hanluu0710/handsfreereading/README.md

# handsfreereading
Senior Design - Hands-free reading
