hanluu0710/handsfreereading/Eye Tracking/Rassberry Pi Camera Mount.pptx

## Board & Camera Module 3 Case + Mount

- Raspberry Pi Camera Mount - Camera Module 3 Version by (https://www.printables.com/model/368788-raspberry-pi-camera-mount-camera-module-3-version/files)DocWeebl (https://www.printables.com/model/368788-raspberry-pi-camera-mount-camera-module-3-version/files) | Download free STL model | Printables.com (https://www.printables.com/model/368788-raspberry-pi-camera-mount-camera-module-3-version/files)
- Articulating Raspberry Pi Camera Mount for Prusa MK3 and MK2 by Sneaks | Download free STL model | Printables.com (https://www.printables.com/model/3407-articulating-raspberry-pi-camera-mount-for-prusa-m)
- Raspberry Pi 4B case with RPi camera 2 arm by Dominik (https://www.printables.com/model/301598-raspberry-pi-4b-case-with-rpi-camera-2-arm)Chuchlík (https://www.printables.com/model/301598-raspberry-pi-4b-case-with-rpi-camera-2-arm) | Download free STL model | Printables.com (https://www.printables.com/model/301598-raspberry-pi-4b-case-with-rpi-camera-2-arm)
