hanluu0710/handsfreereading/Senior Design Purchases.xlsx

Seller | Components | Price | Total spent: | $107.43
Rasberry Pi | Raspberry Pi 4 | $67.50
 | Camera Module | $27.50
 | Shipping | $12.43
