hanluu0710/handsfreereading/Senior Design BOM.xlsx

Component Name | Unit Cost | Unit # to get | Total Cost | Status | Description/Stock size/notes | Manufacturer Part Number | Notes
GC0308 0.3MP 120FPS Camera Module 30MP Sensors for Dynamic Picture, 80 degree black and | $18.37 |  |  |  |  | https://www.amazon.com/PLCPDM-GC0308-Sensors-Dynamic-Picture/dp/B0D6K51LKB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 | Must purchase on own due to foreign adversary limitations, ask if too high level and need to design by ourselves
Servo |  |  |  |  |  |  | Ask ECE schop
Rechargeable battery
protection circuit
prioritizer circuit
