hanluu0710/handsfreereading/Purchasing forms/Digikey Order 1.xlsx

DigiKey - Shopping Cart
Index | Quantity | Part Number | Manufacturer Part Number | Description | Unit of Measure | Customer Reference | Available | Backorder | Unit Price | Extended Price USD
1 | 2 | 296-36206-5-ND | TPS54531DDA | IC REG BUCK ADJ 5A 8SOPWR |  |  | 2 | 0 | 3.04 | 6.08
2 | 2 | 497-18060-1-ND | STUSB4500QTR | IC USB CONTROLLER I2C 24QFN |  |  | 2 | 0 | 2.22 | 4.44
3 | 2 | 497-6689-1-ND | ESDA25W | TVS DIODE 24VWM SOT323 |  |  | 2 | 0 | 0.45 | 0.90
4 | 4 | 497-16913-1-ND | ESDA25P35-1U1M | TVS DIODE 22VWM 41VC 1610 |  |  | 4 | 0 | 0.54 | 2.16
5 | 2 | 5399-SS52CT-ND | SS52 | 20V 550MV@5A 5A SMA(DO-214AC) |  |  | 2 | 0 | 0.11 | 0.22
6 | 1 | 1597-1203-ND | 108990003 | STEPPER MOTOR PM BIPOLAR 5V |  |  | 1 | 0 | 4.9 | 4.90
7 | 1 | 1528-3297-ND | 3297 | EVAL BOARD FOR DRV8833 |  |  | 1 | 0 | 5.95 | 5.95
8 | 2 | BAT54LT1GOSCT-ND | BAT54LT1G | DIODE SCHOTTKY 30V 200MA SOT23-3 |  |  | 2 | 0 | 0.14 | 0.28
9 | 2 | 5923-0686F8000-01CT-ND | 0686F8000-01 | FUSE BRD MNT 8A 32VAC 63VDC 0603 |  |  | 2 | 0 | 0.45 | 0.90
10 | 2 | 2223-UJ20-C-H-G-SMT-1-P16-TRCT-ND | UJ20-C-H-G-SMT-1-P16-TR | CONN RCPT USB 2.0 TYPE C SMD RA |  |  | 2 | 0 | 0.49 | 0.98
11 | 2 | 283-EXLA1V0606-6R8-RCT-ND | EXLA1V0606-6R8-R | FIXED IND 6.8UH 9A 20.8 MOHM SMD |  |  | 2 | 0 | 1.26 | 2.52
12 | 3 | 445-6390-1-ND | MLZ1608M4R7WT000 | FIXED IND 4.7UH 350MA 500 MOHM |  |  | 3 | 0 | 0.1 | 0.30
13 | 3 | 497-15315-1-ND | STL6P3LLH6 | MOSFET P-CH 30V 6A POWERFLAT |  |  | 3 | 0 | 1.72 | 5.16
14 | 4 | FDMC8327LCT-ND | FDMC8327L | MOSFET N-CH 40V 12A/14A 8MLP |  |  | 4 | 0 | 1.54 | 6.16
15 | 1 | 108-DP62J12S202HQ-ND | DP62J12S202HQ | DP SERIES ROCKER SWITCH |  |  | 1 | 0 | 3.73 | 3.73
16 | 2 | BC2733CT-ND | NTCS0805E3103FLT | THERMISTOR NTC 10KOHM 3430K 0805 |  |  | 2 | 0 | 0.79 | 1.58
17 | 2 | 505-LTC4162EUFD-LAD#TRPBFCT-ND | LTC4162EUFD-LAD#TRPBF | IC BATT MON LI-ION 1-8CELL 28QFN |  |  | 2 | 0 | 9.02 | 18.04
