hanluu0710/handsfreereading/Purchasing forms/ECE Senior Design Purchase Request - Digikey.xlsx

FOR SENIOR DESIGN USE ONLY
 |  |  |  |  | Today's Date: | 2026-10-31
College of Engineering Senior Design Purchase Request Form |  |  | Department Name: |  | Need-By Date: | 2026-11-07
 |  |  | ECE |  | SHIP TO INFORMATION
Vendor: | Digikey |  | Team Name / Project: |  | Your Name: | Han Luu
Website: | https://www.digikey.com/ |  | Hands-free Reading |  | Building Abbv.: | BHEE
Phone Number: | 18003444539 |  |  |  | Room Number: | 65
Vendor Contact: |  |  | Account Number: (do not change) |  | Phone Number: | 6265453735
Contact Email: | orders@digikey.com |  | 7600000796 |  | Email Address: | luum@purdue.edu
 |  |  | DIGIKEY ORDERS WITH MORE THAN 5 LINES ITEMS MUST ATTACH EXCEL DOWNLOAD OF SHOPPING CART FROM DIGIKEY CATALOG |  | Instructor: | Carla Zoltowski and Ryan Beasley
 |  |  | IF NO EXCEL DOWNLOAD ATTACH, REQUEST WILL BE REJECTED
PART NUMBER |  | ITEM DESCRIPTION & LINK |  |  |  | QUANTITY | UNIT COST | TOTAL COST
TPS54531DDA |  | IC REG BUCK ADJ 5A 8SOPWR https://www.digikey.com/en/products/detail/texas-instruments/TPS54531DDA/4172337 |  |  |  | 2.00 | $3.04 | $6.08
STUSB4500QTR |  | IC USB CONTROLLER I2C 24QFN https://www.digikey.com/en/products/detail/stmicroelectronics/STUSB4500QTR/9092189 |  |  |  | 2.00 | $2.22 | $4.44
ESDA25W |  | TVS DIODE 24VWM SOT323 https://www.digikey.com/en/products/detail/stmicroelectronics/ESDA25W/1037976 |  |  |  | 2.00 | $0.45 | $0.90
ESDA25P35-1U1M |  | TVS DIODE 22VWM 41VC 1610 https://www.digikey.com/en/products/detail/stmicroelectronics/ESDA25P35-1U1M/6230124 |  |  |  | 4.00 | $0.54 | $2.16
SS52 |  | 20V 550MV@5A 5A SMA(DO-214AC) https://www.digikey.com/en/products/detail/shenzhen-slkormicro-semicon-co-ltd/SS52/26370980 |  |  |  | 2.00 | $0.11 | $0.22
108990003 |  | STEPPER MOTOR PM BIPOLAR 5V https://www.digikey.com/en/products/detail/seeed-technology-co-ltd/108990003/5487797 |  |  |  | 1.00 | $4.90 | $4.90
3297 |  | EVAL BOARD FOR DRV8833 https://www.digikey.com/en/products/detail/adafruit-industries-llc/3297/6419360 |  |  |  | 1.00 | $5.95 | $5.95
BAT54LT1G |  | DIODE SCHOTTKY 30V 200MA SOT23-3 https://www.digikey.com/en/products/detail/onsemi/BAT54LT1G/918316 |  |  |  | 2.00 | $0.14 | $0.28
0686F8000-01 |  | FUSE BRD MNT 8A 32VAC 63VDC 0603 https://www.digikey.com/en/products/detail/bel-fuse-inc/0686F8000-01/7427698 |  |  |  | 2.00 | $0.45 | $0.90
UJ20-C-H-G-SMT-1-P16-TR |  | CONN RCPT USB 2.0 TYPE C SMD RA https://www.digikey.com/en/products/detail/same-sky-formerly-cui-devices/UJ20-C-H-G-SMT-1-P16-TR/24818576 |  |  |  | 2.00 | $0.49 | $0.98
EXLA1V0606-6R8-R |  | FIXED IND 6.8UH 9A 20.8 MOHM SMD https://www.digikey.com/en/products/detail/eaton-electronics-division/EXLA1V0606-6R8-R/16892708 |  |  |  | 2.00 | $1.26 | $2.52
MLZ1608M4R7WT000 |  | FIXED IND 4.7UH 350MA 500 MOHM TDK https://www.digikey.com/en/products/detail/tdk/MLZ1608M4R7WT000/2465149 |  |  |  | 3.00 | $0.10 | $0.30
STL6P3LLH6 |  | MOSFET P-CH 30V 6A POWERFLAT https://www.digikey.com/en/products/detail/stmicroelectronics/STL6P3LLH6/5170838 |  |  |  | 3.00 | $1.72 | $5.16
FDMC8327L |  | MOSFET N-CH 40V 12A/14A 8MLP https://www.digikey.com/en/products/detail/onsemi/FDMC8327L/3855013 |  |  |  | 4.00 | $1.54 | $6.16
DP62J12S202HQ |  | DP SERIES ROCKER SWITCH https://www.digikey.com/en/products/detail/c-k/DP62J12S202HQ/26715630 |  |  |  | 1.00 | $3.73 | $3.73
NTCS0805E3103FLT |  | THERMISTOR NTC 10KOHM 3430K 0805 https://www.digikey.com/en/products/detail/vishay-beyschlag-draloric-bc-components/NTCS0805E3103FLT/2615416 |  |  |  | 2.00 | $0.79 | $1.58
LTC4162EUFD-LAD#TRPBF |  | IC BATT MON LI-ION 1-8CELL 28QFN https://www.digikey.com/en/products/detail/analog-devices-inc/LTC4162EUFD-LAD-TRPBF/9446057 |  |  |  | 2.00 | $9.02 | $18.04
Shipping / Handling |  |  |  |  |  |  | $24.84 | $24.84
Requisition Total |  |  |  |  |  |  |  | $89.14
*** ALL BLUE CELLS are Mandatory *** Do Not Alter Formulas ***
Required Approvals |  |  |  | Business Office Use Only:
Instructor: |  |  |  | CC - Trans ID# |  | Credit Card# (last four only):
 | Signature |  | Date | Reimbursement / Check payment - Ref. Doc#
Comptroller/Fiscal:
 | Signature |  | Date | Is there a discount? Yes______ No ______ (Fill out the Form 41B)
