hanluu0710/handsfreereading/Circuit/handsfreereading_PCB/Reference_symbol/Ref_Sym/Batt_holder1122/1122.step

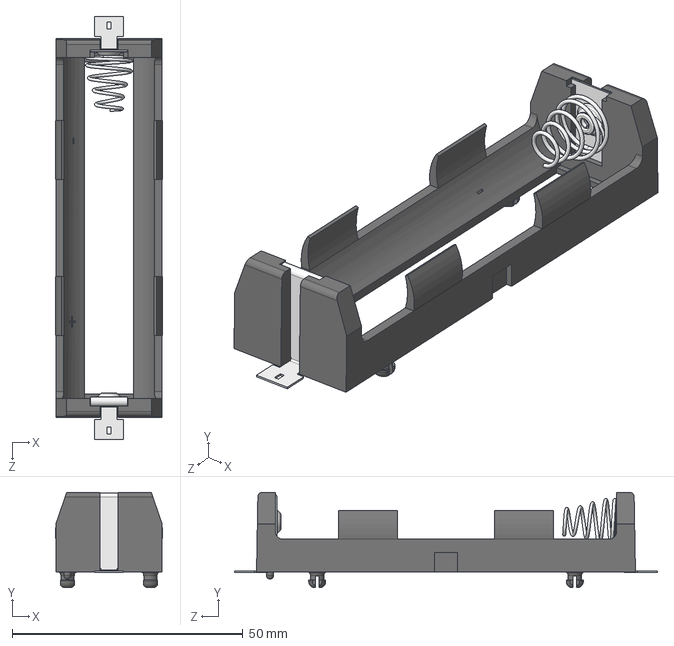
[picture p38: CAD file, 2026-11-04]
Circuit/handsfreereading_PCB/Reference_symbol/Ref_Sym/Batt_holder1122/1122.step
23.3 x 20.7 x 91.7 mm
