hanluu0710/handsfreereading/Eye Tracking/Rassberry Pi 4b Getting Started.pptx

Prototyping

Final version

WARNING

RP-008341-DS-1-raspberry-pi-4-datasheet.pdf (https://pip-assets.raspberrypi.com/categories/545-raspberry-pi-4-model-b/documents/RP-008341-DS-1-raspberry-pi-4-datasheet.pdf)

## Slide 2

Need a USB-C cable for power only.

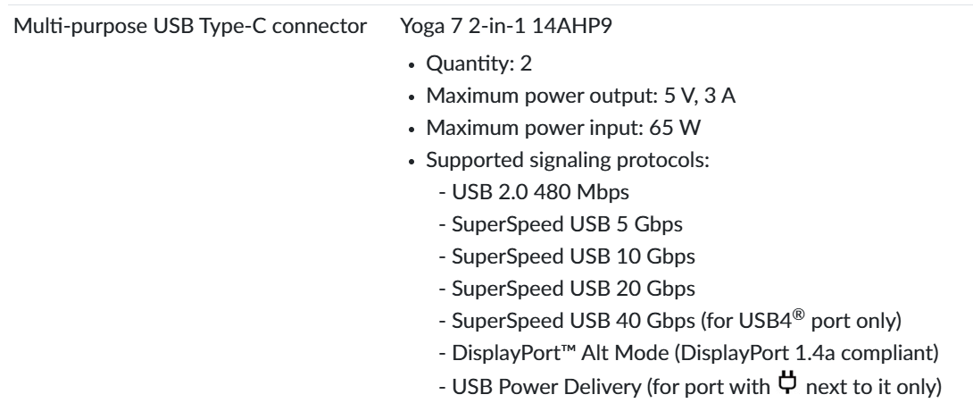
[picture p39: figure]
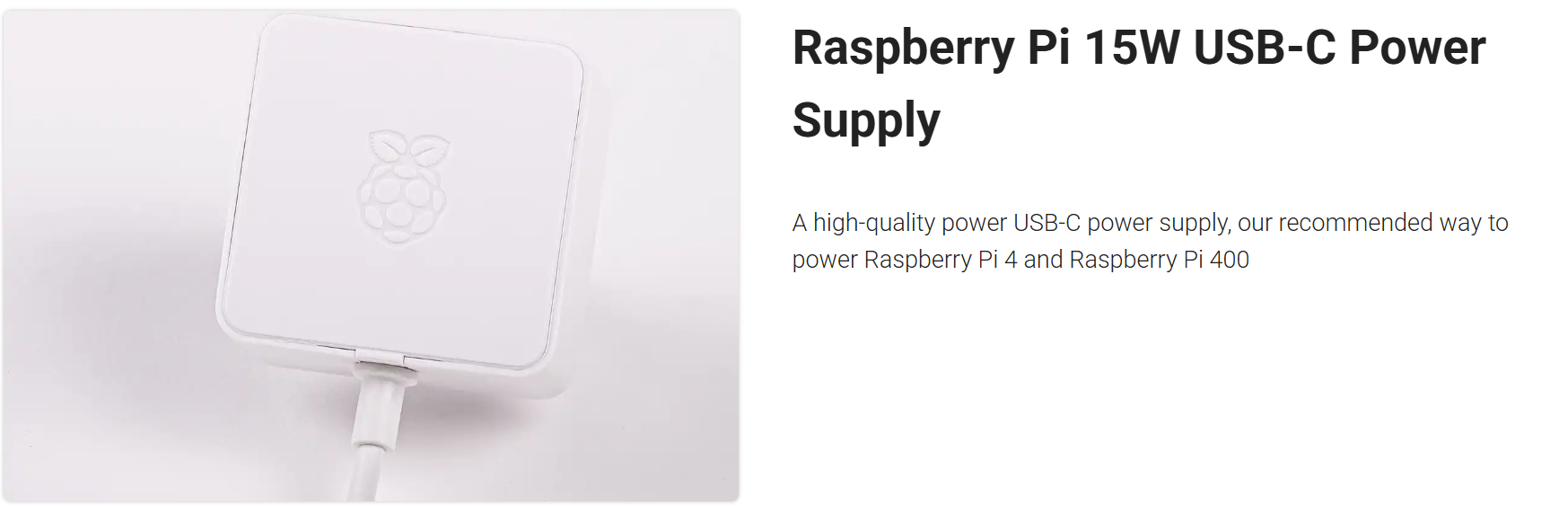
[picture p40: figure]

Optional

## Slide 3

If we did not purchase the pre-loaded SD card, we will have to follow these steps (https://www.raspberrypi.com/documentation/computers/getting-started.html#install).

If you want to work on this, you need a Micro SD card port on your laptop.

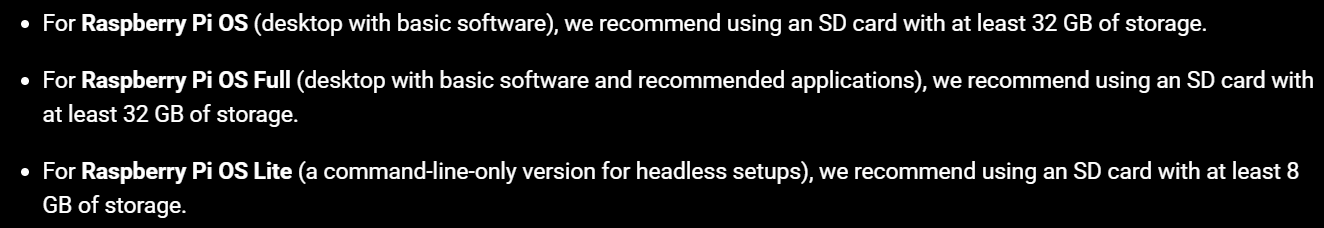
[picture p41: figure]

WARNING

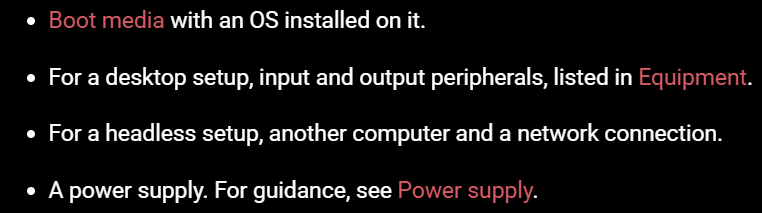
[picture p42: figure]

## Slide 4

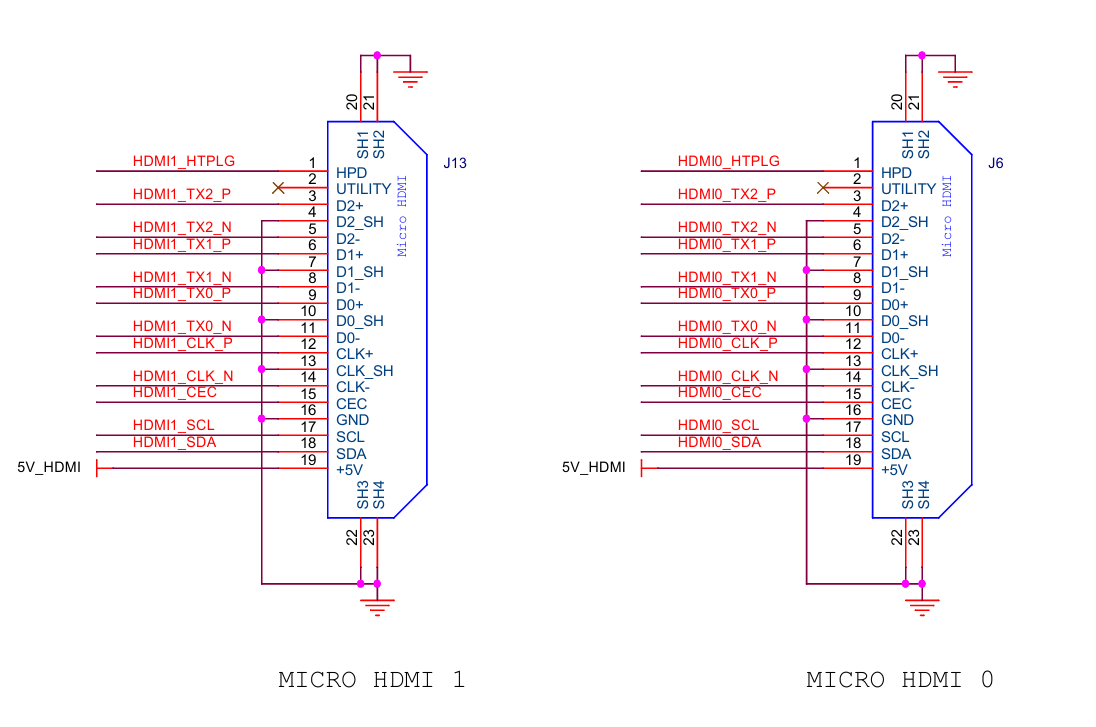
[picture p43: figure]

Need to purchase or get a micro-HDMI to HDMI/USB cable/converter/adapter to display live camera feedon Windows PC Monitor from Rasberry Pi.

The HDMI port on most laptops is output-only.

## Slide 5

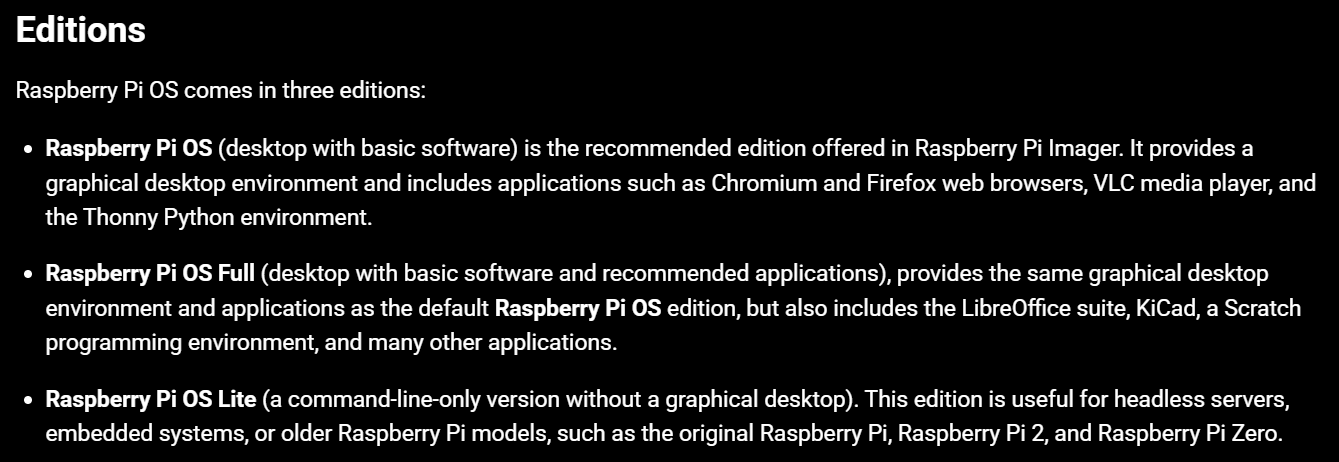
[picture p44: figure]

For independent subsystem prototyping and testing.

Final version with no graphics.

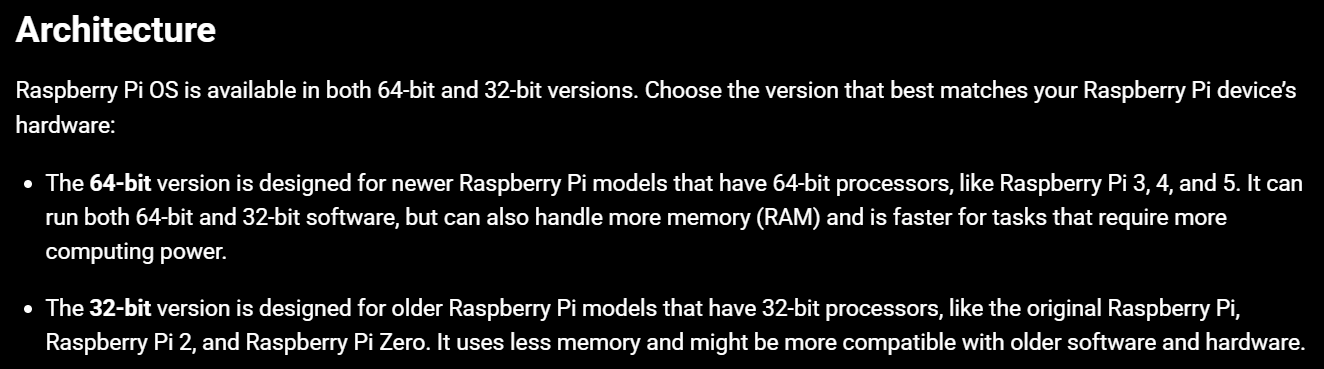
[picture p45: figure]

## Slide 6

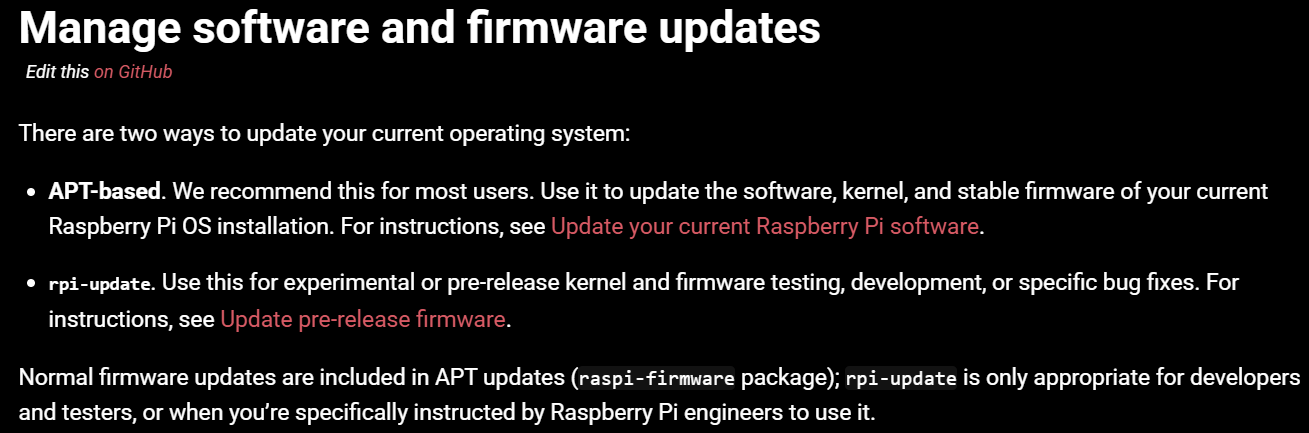
[picture p46: figure]
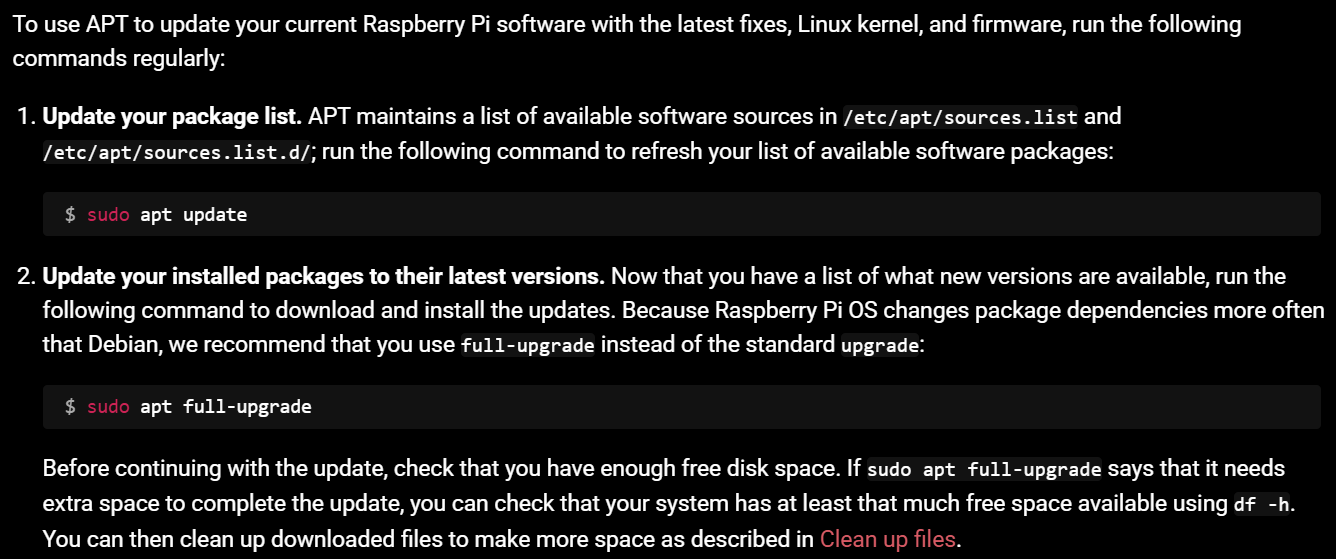
[picture p47: figure]

How to keep firmware updated.

## Setting up Camera

Datasheet (https://pip-assets.raspberrypi.com/categories/786-raspberry-pi-camera-module-3/documents/RP-008151-DS-1-camera-module-3-product-brief.pdf)

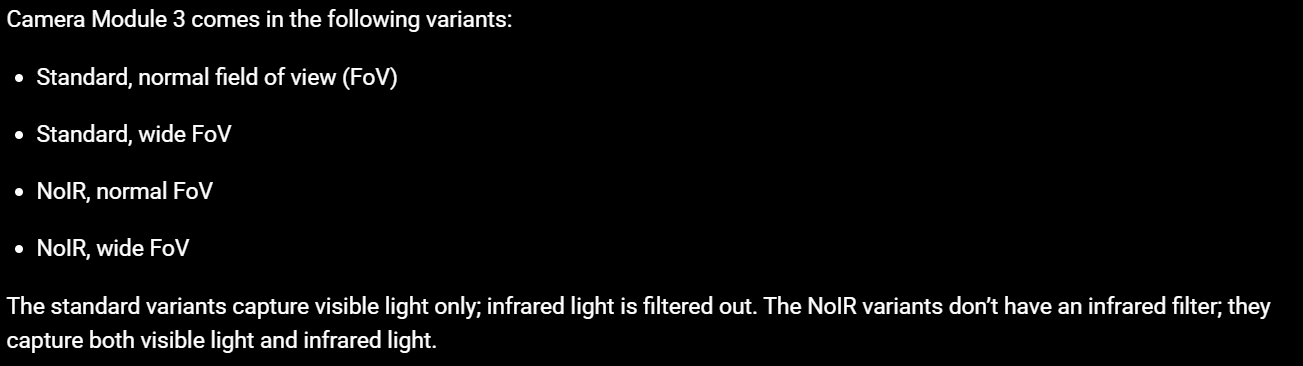
[picture p48: figure]

Getting started with the Camera Module | Python | Coding projects for kids and teens (https://projects.raspberrypi.org/en/projects/getting-started-with-picamera/0)
