hanluu0710/handsfreereading/Circuit/handsfreereading_PCB/handsfreereading_PCB.kicad_pcb

## KiCad design pcb/pcb.kicad_sch

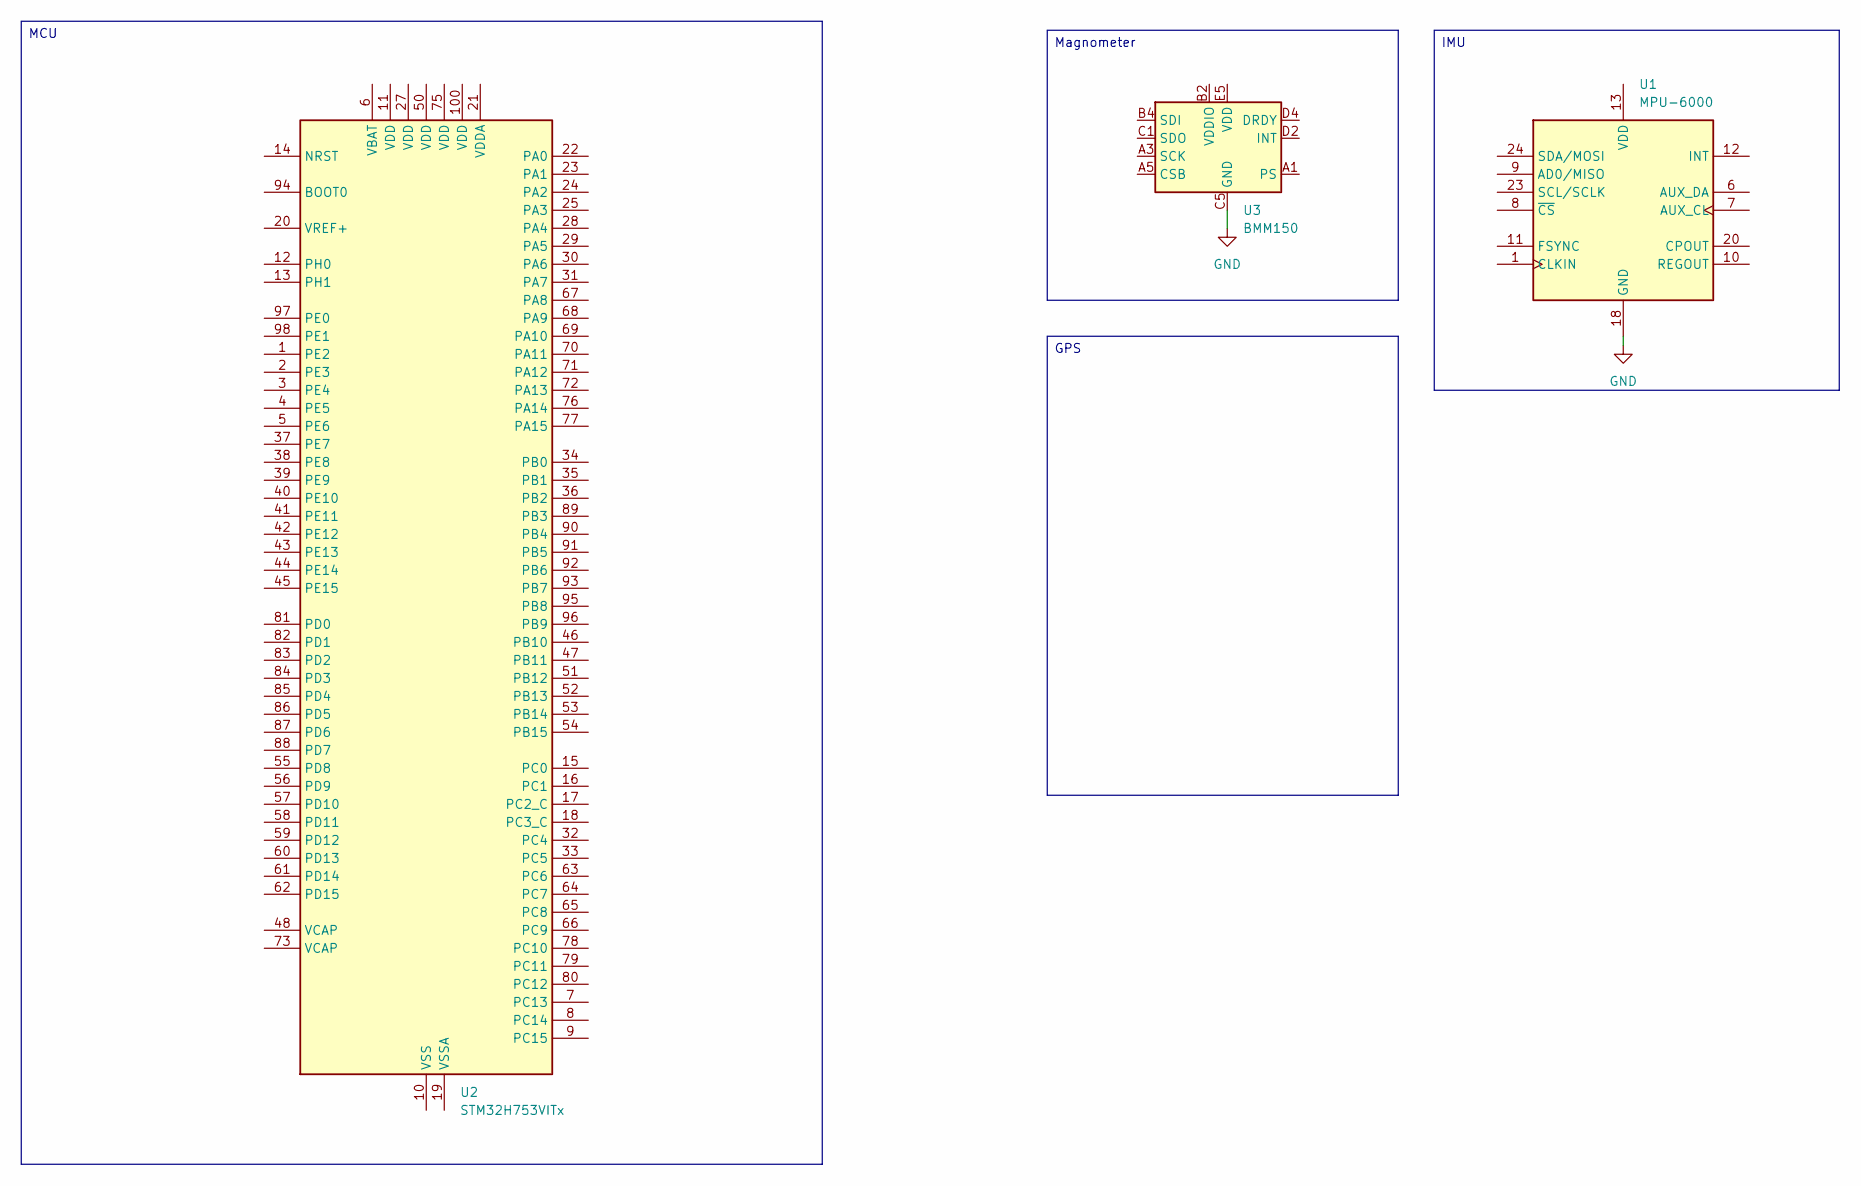
[picture p49: schematic pcb.kicad_sch]

Parts:
U1: MPU-6000; InvenSense_QFN-24_4x4mm_P0.5mm
U2: STM32H753VITx; LQFP-100_14x14mm_P0.5mm
U3: BMM150; WLCSP-12_1.56x1.56mm_P0.4mm

Connections:
GND: U1.18 (GND), U3.C5 (GND), U3.E1 (GND), U3.E3 (GND)
unnamed: U2.10 (VSS), U2.26 (VSS), U2.49 (VSS), U2.74 (VSS), U2.99 (VSS)

Notes on the sheet:
IMU
GPS
Magnometer
MCU
