hanluu0710/handsfreereading/(commit log)

2026-10-17 Power circuit
    [handsfreereading_PCB.kicad_sch]
2026-11-02 New approach to power design
    [Book.xlsx, ECE Senior Design Purchase Request - Digikey.xlsx, Power Consumption.xlsx, Senior Design Purchases.xlsx, handsfreereading_PCB.kicad_sch]
2026-11-03 more power
    [handsfreereading_PCB.kicad_sch]
2026-11-04 more power stuff
    [BMS.kicad_sch, Power Consumption.xlsx, charging_circuit.kicad_sch, handsfreereading_PCB.kicad_sch, usbc_circuit.kicad_sch]
2026-11-04 assigning footprint
    [1122.step, Power Consumption.xlsx, charging_circuit.kicad_sch, usbc_circuit.kicad_sch]
2026-11-05 done assigning footprint
    [Spec Sheet.ods, charging_circuit.kicad_sch, handsfreereading_PCB.kicad_sch, usbc_circuit.kicad_sch]
2026-11-07 changed location
    [1122.step]
